RuzickaOndra/Aurora/HW/MermaidControlUnit_A/MermaidControlUnit_Schematic_A.pdf

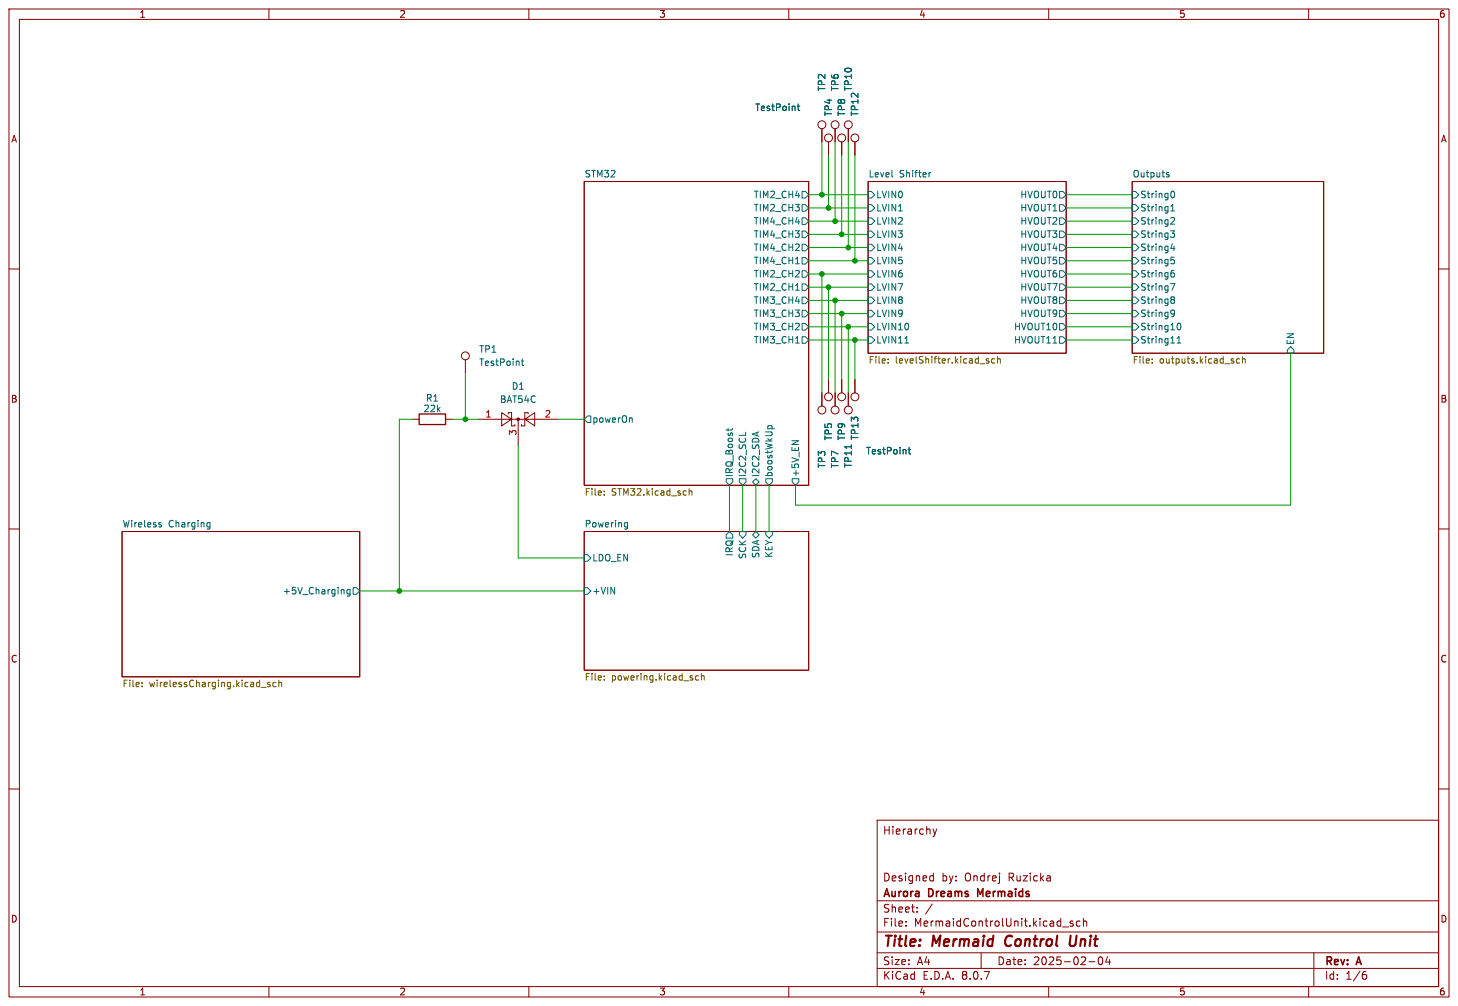
[picture p1: page 1]

Level Shifter File: levelShifter.kicad_sch IRQ SCK SDA KEY LDO_EN

Outputs File: outputs.kicad_sch TIM4_CH3 TIM4_CH4 I2C2_SCL I2C2_SDA boostWkUp

+5V_Charging Wireless Charging File: wirelessCharging.kicad_sch

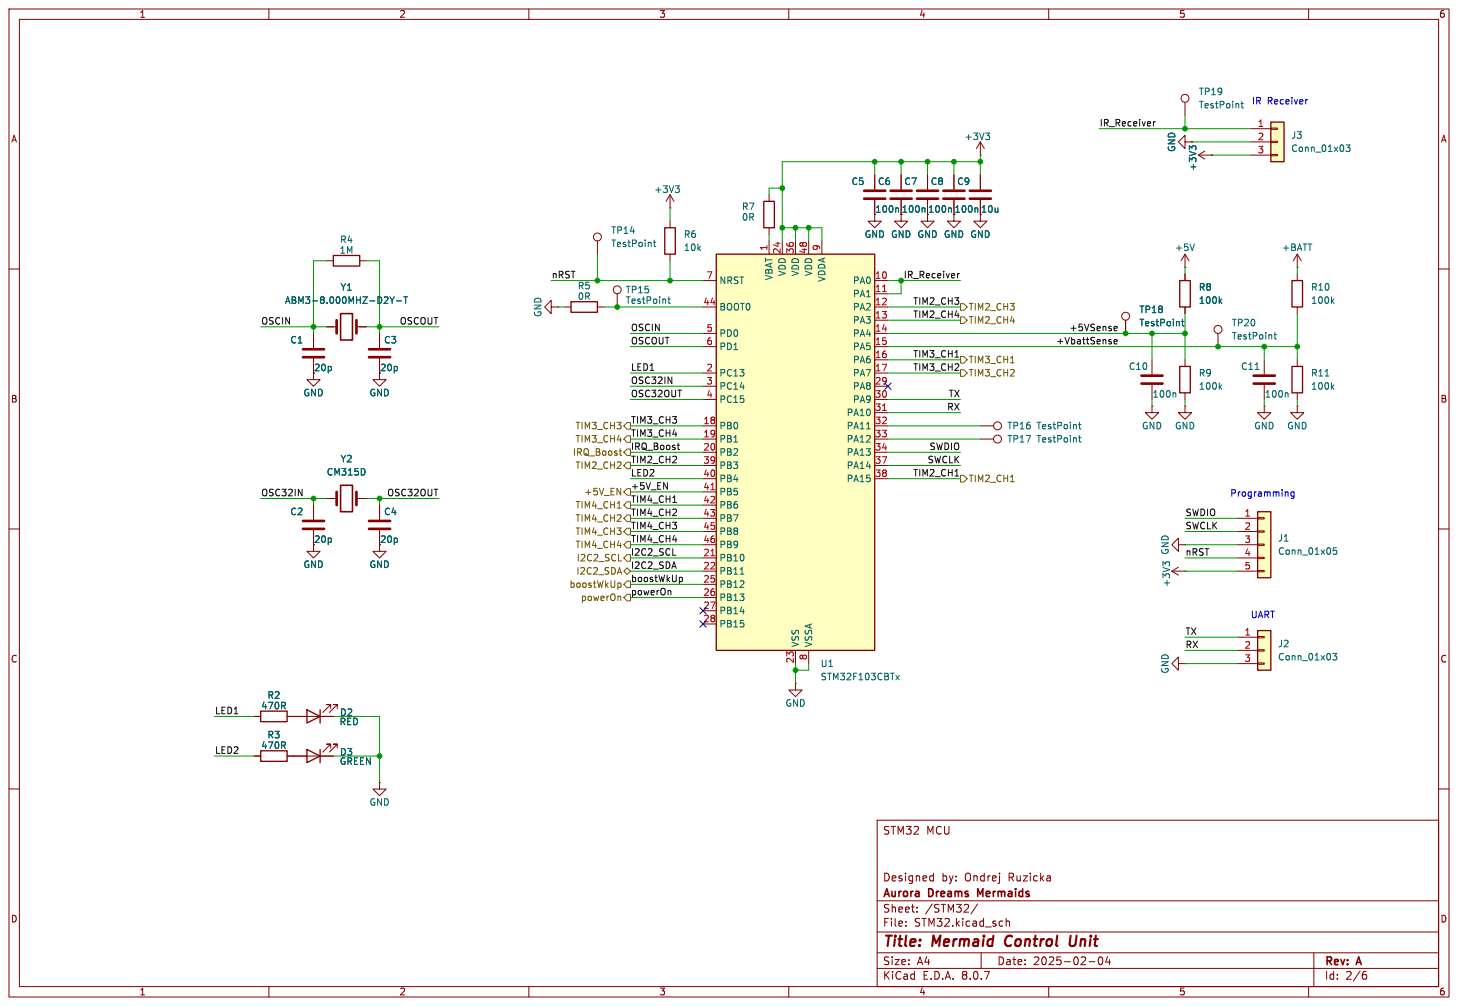
[picture p2: page 2]

IR Receiver GND GND

1 PA0 10 PA1 11 PA2 12 PA3 13 PA4 14 PA5 15 PA6 16 PA7 17 PB0 18 PB1 19 PC13 2 PB2 20 PB10 21 PB11 22 VSS 23 VDD 24 PB12 25 PB13 26 PB14 27 PB15 28 PA8 29 PC14 3 PA9 30 PA10 31 PA11 32 PA12 33 PA13 34 VDD 36 PA14 37 PA15 38 PB3 39 PC15 4 PB4 40 PB5 41 PB6 42 PB7 43 BOOT0 44 PB8 45 PB9 46 VDD 48 PD0 5 PD1 6 NRST 7 VSSA

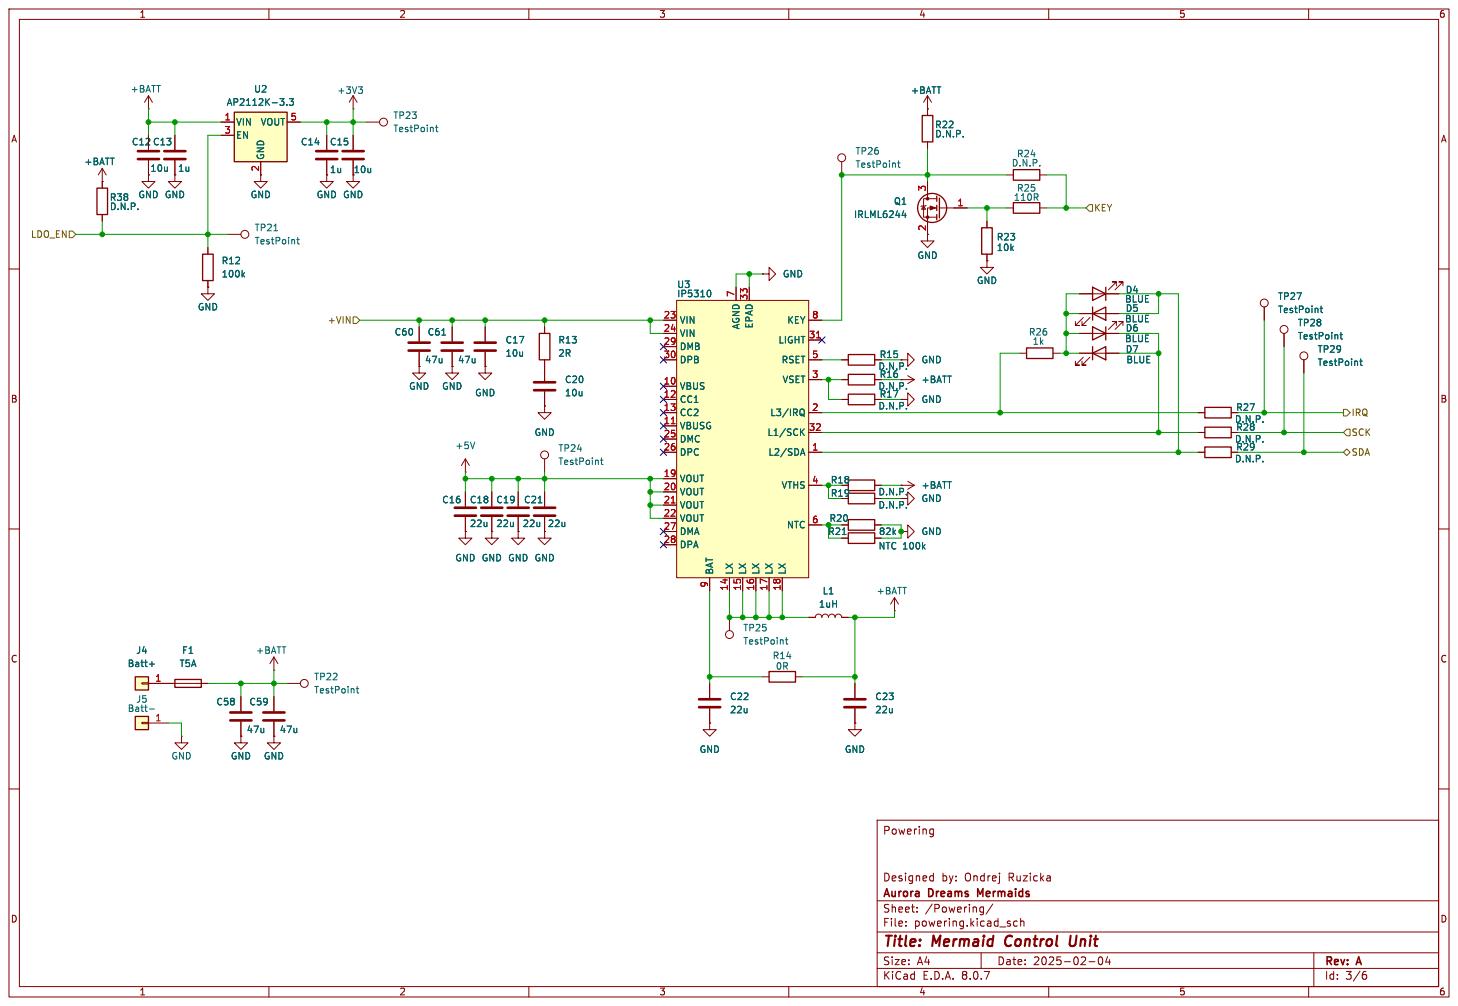
[picture p3: page 3]

TP27 TestPoint TP28 TestPoint TP29 TestPoint GND

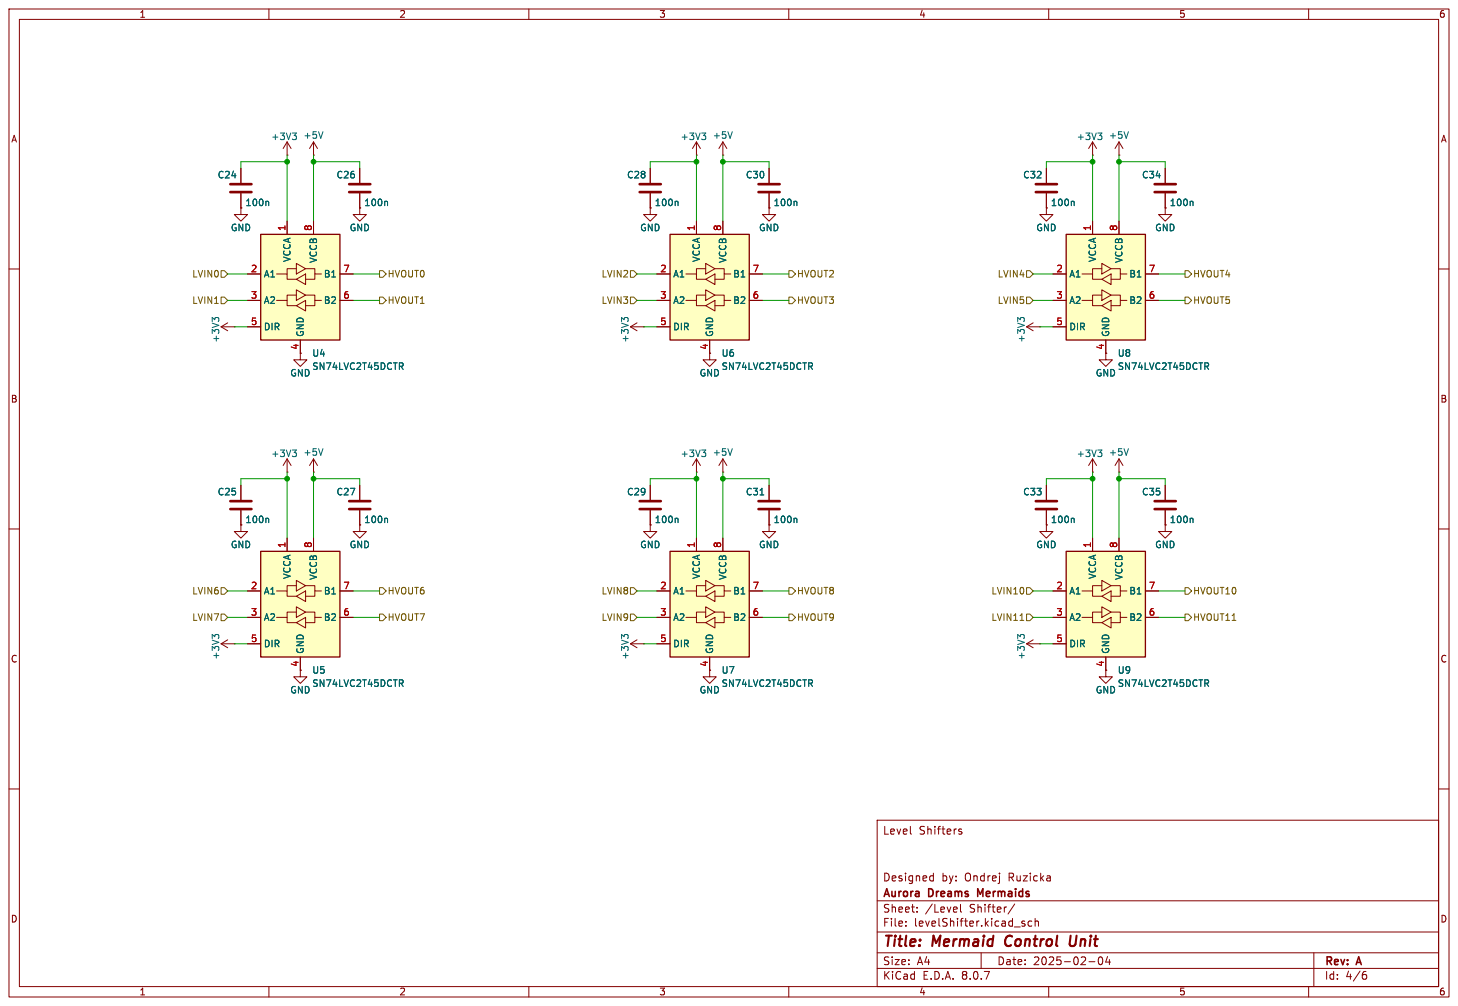
[picture p4: page 4]

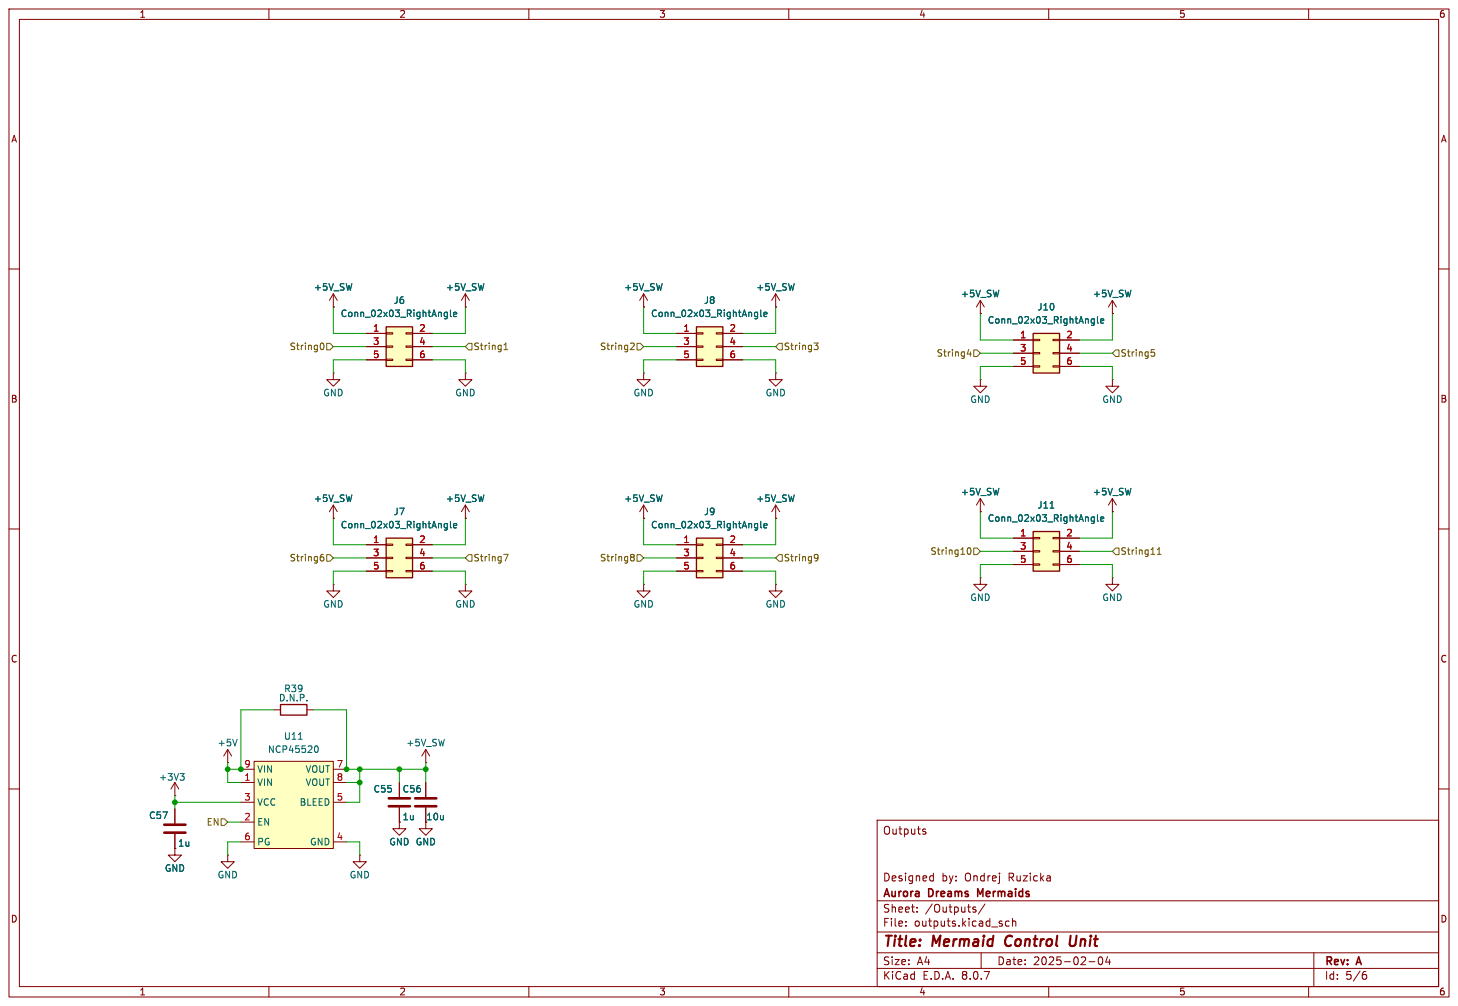
[picture p5: page 5]

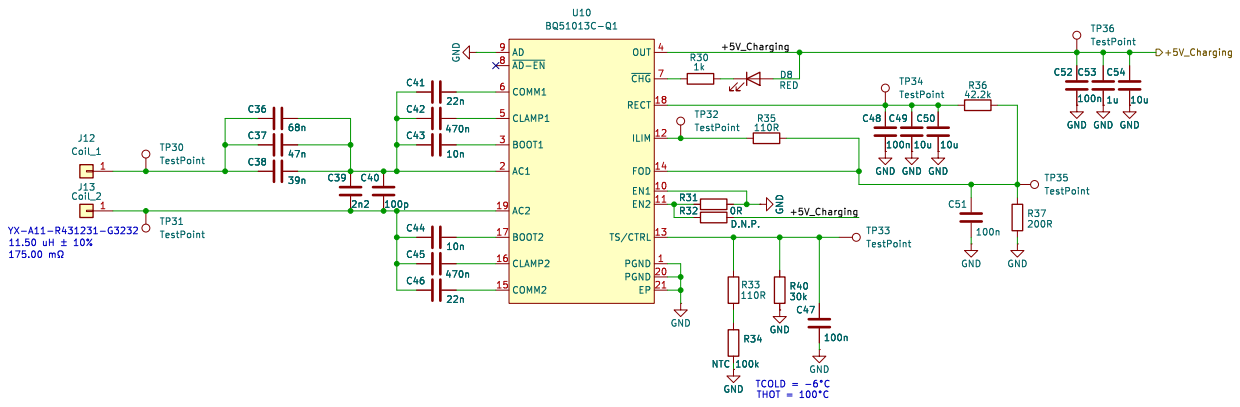
[picture p6: page 6]
