RuzickaOndra/Aurora/HW/Demo/Schematic_Prototype.pdf

A | A

1

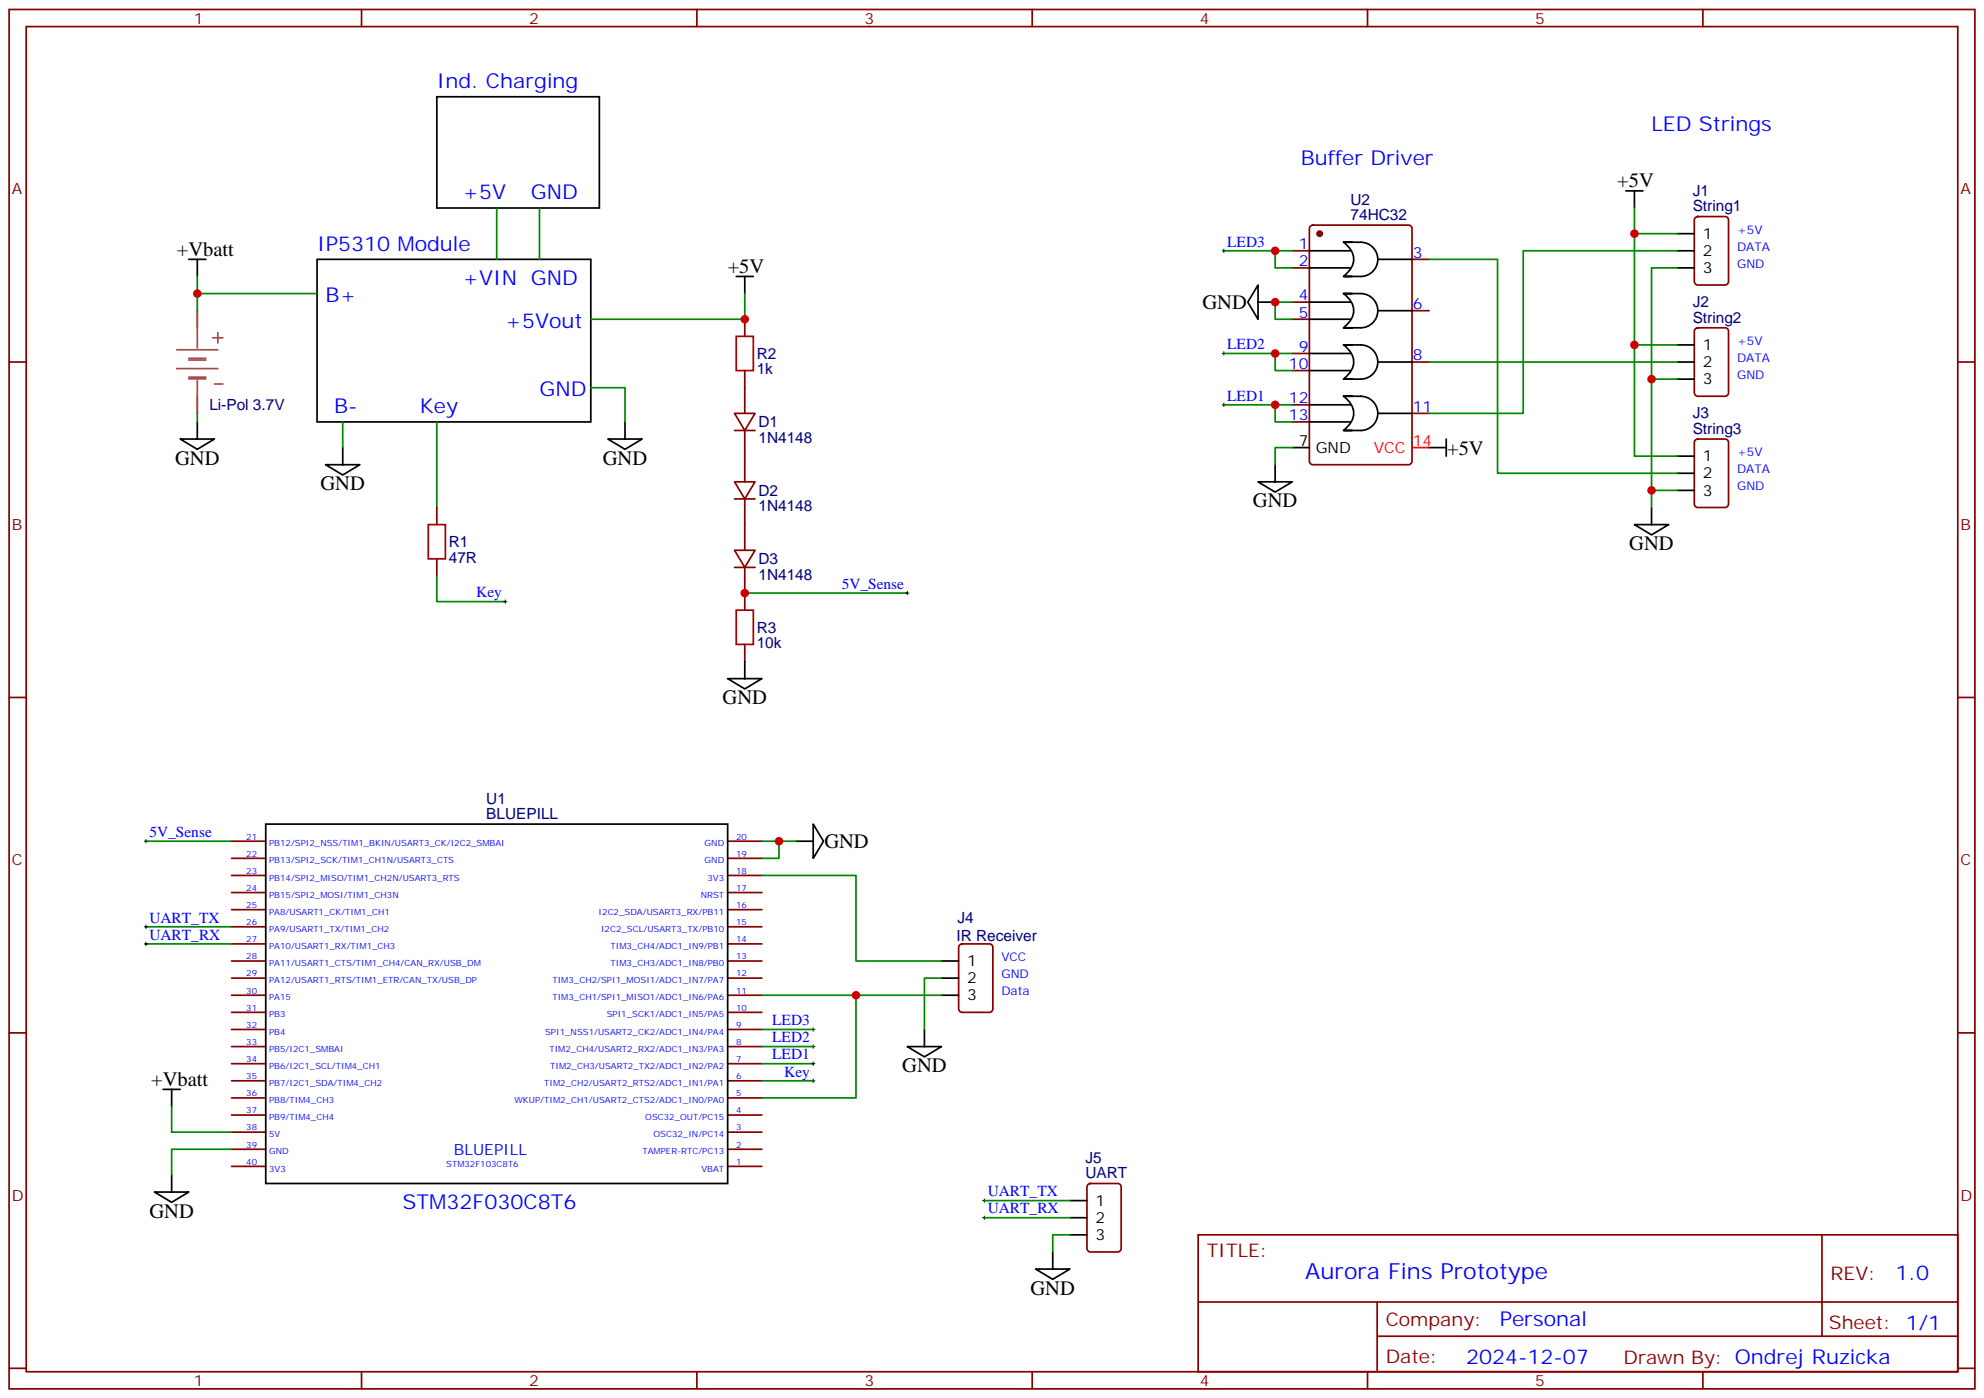
[picture p7: page 1]

Drawn By: Ondrej Ruzicka
