RuzickaOndra/Aurora/HW/MermaidControlUnit_A/KiCAD_Project/MermaidControlUnit.kicad_pcb

## KiCad design HW/MermaidControlUnit_A/KiCAD_Project/MermaidControlUnit.kicad_pcb (2025-03-04)

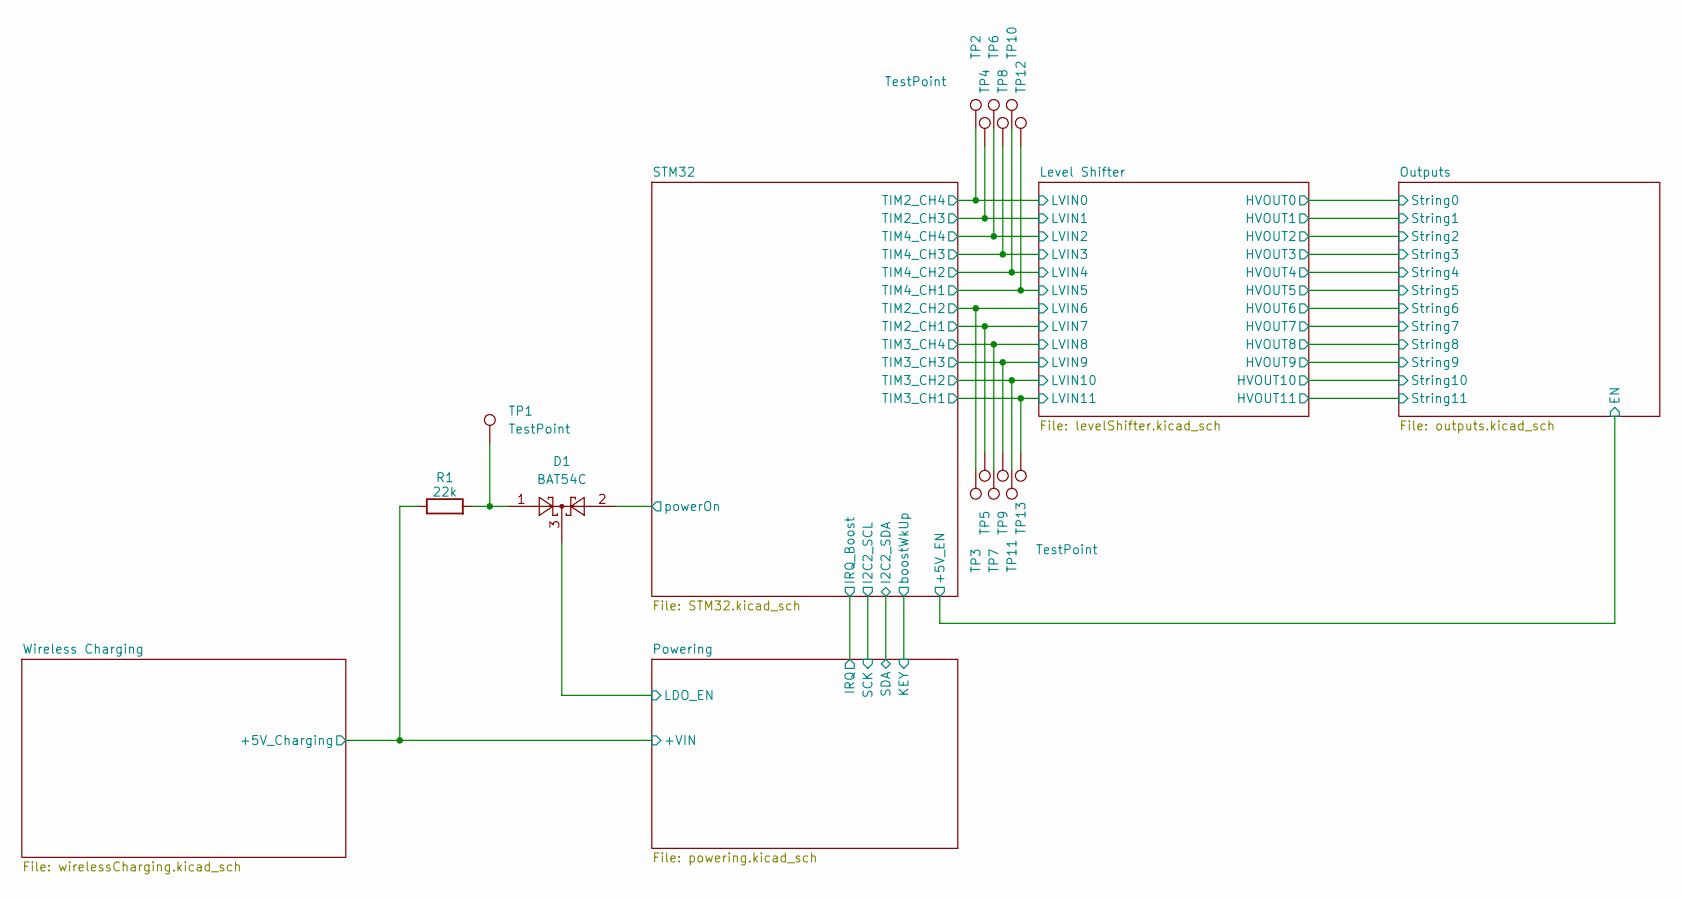
[picture p8: schematic MermaidControlUnit.kicad_sch, Mermaid Control Unit]

Parts:
D1: BAT54C; SOT-23; Part Number BAT54CLT1G
R1: 22k; R_0603_1608Metric; Part Number RC0603FR-0722KL
TP1, TP2, TP3, TP4, TP5, TP6, TP7, TP8, TP9, TP10, TP11, TP12, TP13: TestPoint; TestPoint_Pad_D1.5mm

Connections:
/Powering/LDO_EN: D1.3; also elsewhere on the board
/STM32/TIM2_CH1: TP5.1; also elsewhere on the board
/STM32/TIM2_CH2: TP3.1; also elsewhere on the board
/STM32/TIM2_CH3: TP4.1; also elsewhere on the board
/STM32/TIM2_CH4: TP2.1; also elsewhere on the board
/STM32/TIM3_CH1: TP13.1; also elsewhere on the board
/STM32/TIM3_CH2: TP11.1; also elsewhere on the board
/STM32/TIM3_CH3: TP9.1; also elsewhere on the board
/STM32/TIM3_CH4: TP7.1; also elsewhere on the board
/STM32/TIM4_CH1: TP12.1; also elsewhere on the board
/STM32/TIM4_CH2: TP10.1; also elsewhere on the board
/STM32/TIM4_CH3: TP8.1; also elsewhere on the board
/STM32/TIM4_CH4: TP6.1; also elsewhere on the board
/STM32/powerOn: D1.2; also elsewhere on the board
/Wireless Charging/+5V_Charging: R1.1; also elsewhere on the board
unnamed: D1.1, R1.2, TP1.1

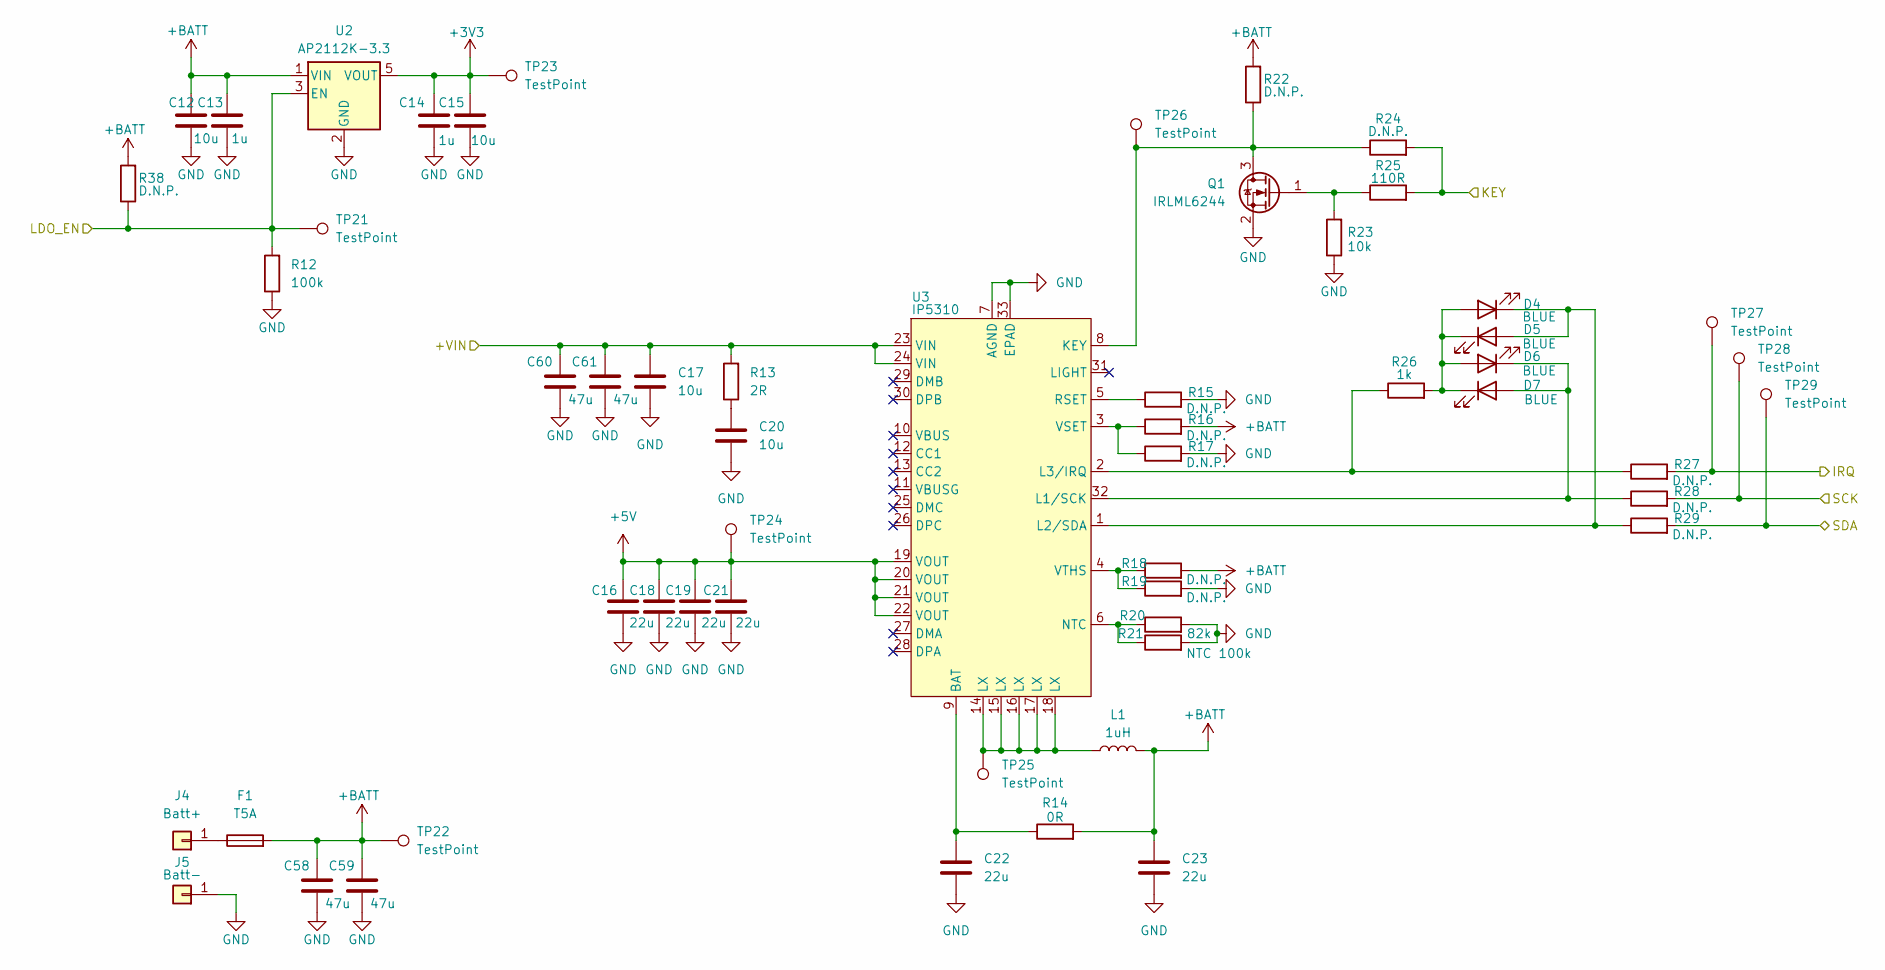
[picture p9: schematic powering.kicad_sch, Mermaid Control Unit]

Parts:
C12, C15, C17, C20: 10u; C_0603_1608Metric; Part Number CL10A106MA8NRNC
C13, C14: 1u; C_0603_1608Metric; Part Number CL10A105KB8NNNC
C16, C18, C19, C21, C22, C23: 22u; C_0603_1608Metric; Part Number CL10A226MP8NUNE
C58, C59, C60, C61: 47u; C_0805_2012Metric; Part Number GRM21BR61A476ME15L
D4, D5, D6, D7: BLUE; LED_0603_1608Metric; Part Number APT1608QBC/D
F1: T5A; Fuse_0603_1608Metric; Part Number F0603HI8000V032TM
J4: Batt+; TestPoint_THTPad_2.0x2.0mm_Drill1.0mm
J5: Batt-; TestPoint_THTPad_2.0x2.0mm_Drill1.0mm
L1: 1uH; L_PCC-M1040M-LP; Part Number ETQP4M1R0KVC
Q1: IRLML6244; SOT-23; Part Number IRLML6244TRPBF
R12: 100k; R_0603_1608Metric; Part Number RC0603FR-07100KL
R13: 2R; R_0603_1608Metric; Part Number FRC0603F2R00TS
R14: 0R; R_0603_1608Metric; Part Number RC0603FR-070RL
R15, R16, R17, R18, R19, R22, R24, R27, R28, R29, R38: D.N.P.; R_0603_1608Metric
R20: 82k; R_0603_1608Metric; Part Number RC0603FR-0782KL
R21: NTC 100k; R_0603_1608Metric; Part Number NCU18WF104F6SRB
R23: 10k; R_0603_1608Metric; Part Number RC0603FR-0710KL
R25: 110R; R_0603_1608Metric; Part Number 0603WAF1100T5E
R26: 1k; R_0603_1608Metric; Part Number RC0603FR-071KL
TP21, TP22, TP23, TP24, TP25, TP26, TP27, TP28, TP29: TestPoint; TestPoint_Pad_D1.5mm
U2: AP2112K-3.3; SOT-23-5; Part Number AP2112K-3.3TRG1
U3: IP5310; QFN-32-1EP_5x5mm_P0.5mm_EP3.6x3.6mm_ThermalVias; Part Number IP5310

Connections:
+3V3: C14.1, C15.1, TP23.1, U2.5 (VOUT); also elsewhere on the board
+5V: C16.1, C18.1, C19.1, C21.1, TP24.1, U3.19 (VOUT), U3.20 (VOUT), U3.21 (VOUT), U3.22 (VOUT); also elsewhere on the board
+BATT: C12.1, C13.1, C23.1, C58.1, C59.1, F1.2, L1.2, R14.2, R16.2, R18.2, R22.2, R38.2, TP22.1, U2.1 (VIN); also elsewhere on the board
/Powering/LDO_EN: R12.2, R38.1, TP21.1, U2.3 (EN); also elsewhere on the board
/STM32/I2C2_SCL: R28.2, TP28.1; also elsewhere on the board
/STM32/I2C2_SDA: R29.2, TP29.1; also elsewhere on the board
/STM32/IRQ_Boost: R27.2, TP27.1; also elsewhere on the board
/STM32/boostWkUp: R24.2, R25.2; also elsewhere on the board
/Wireless Charging/+5V_Charging: C17.1, C60.1, C61.1, R13.2, U3.23 (VIN), U3.24 (VIN); also elsewhere on the board
GND: C12.2, C13.2, C14.2, C15.2, C16.2, C17.2, C18.2, C19.2, C20.2, C21.2, C22.2, C23.2, C58.2, C59.2, C60.2, C61.2, J5.1, Q1.2 (S), R12.1, R15.2, R17.2, R19.2, R20.2, R21.2, R23.1, U2.2 (GND), U3.7 (AGND), U3.33 (EPAD); also elsewhere on the board
unnamed: C20.1, R13.1
unnamed: D4.2 (A), D5.1 (K), D6.2 (A), D7.1 (K), R26.2
unnamed: D4.1 (K), D5.2 (A), R29.1, U3.1 (L2/SDA)
unnamed: D6.1 (K), D7.2 (A), R28.1, U3.32 (L1/SCK)
unnamed: F1.1, J4.1
unnamed: L1.1, TP25.1, U3.14 (LX), U3.15 (LX), U3.16 (LX), U3.17 (LX), U3.18 (LX)
unnamed: Q1.3 (D), R22.1, R24.1, TP26.1, U3.8 (KEY)
unnamed: Q1.1 (G), R23.2, R25.1
unnamed: C22.1, R14.1, U3.9 (BAT)
unnamed: R26.1, R27.1, U3.2 (L3/IRQ)
unnamed: R20.1, R21.1, U3.6 (NTC)
unnamed: R15.1, U3.5 (RSET)
unnamed: R16.1, R17.1, U3.3 (VSET)
unnamed: R18.1, R19.1, U3.4 (VTHS)

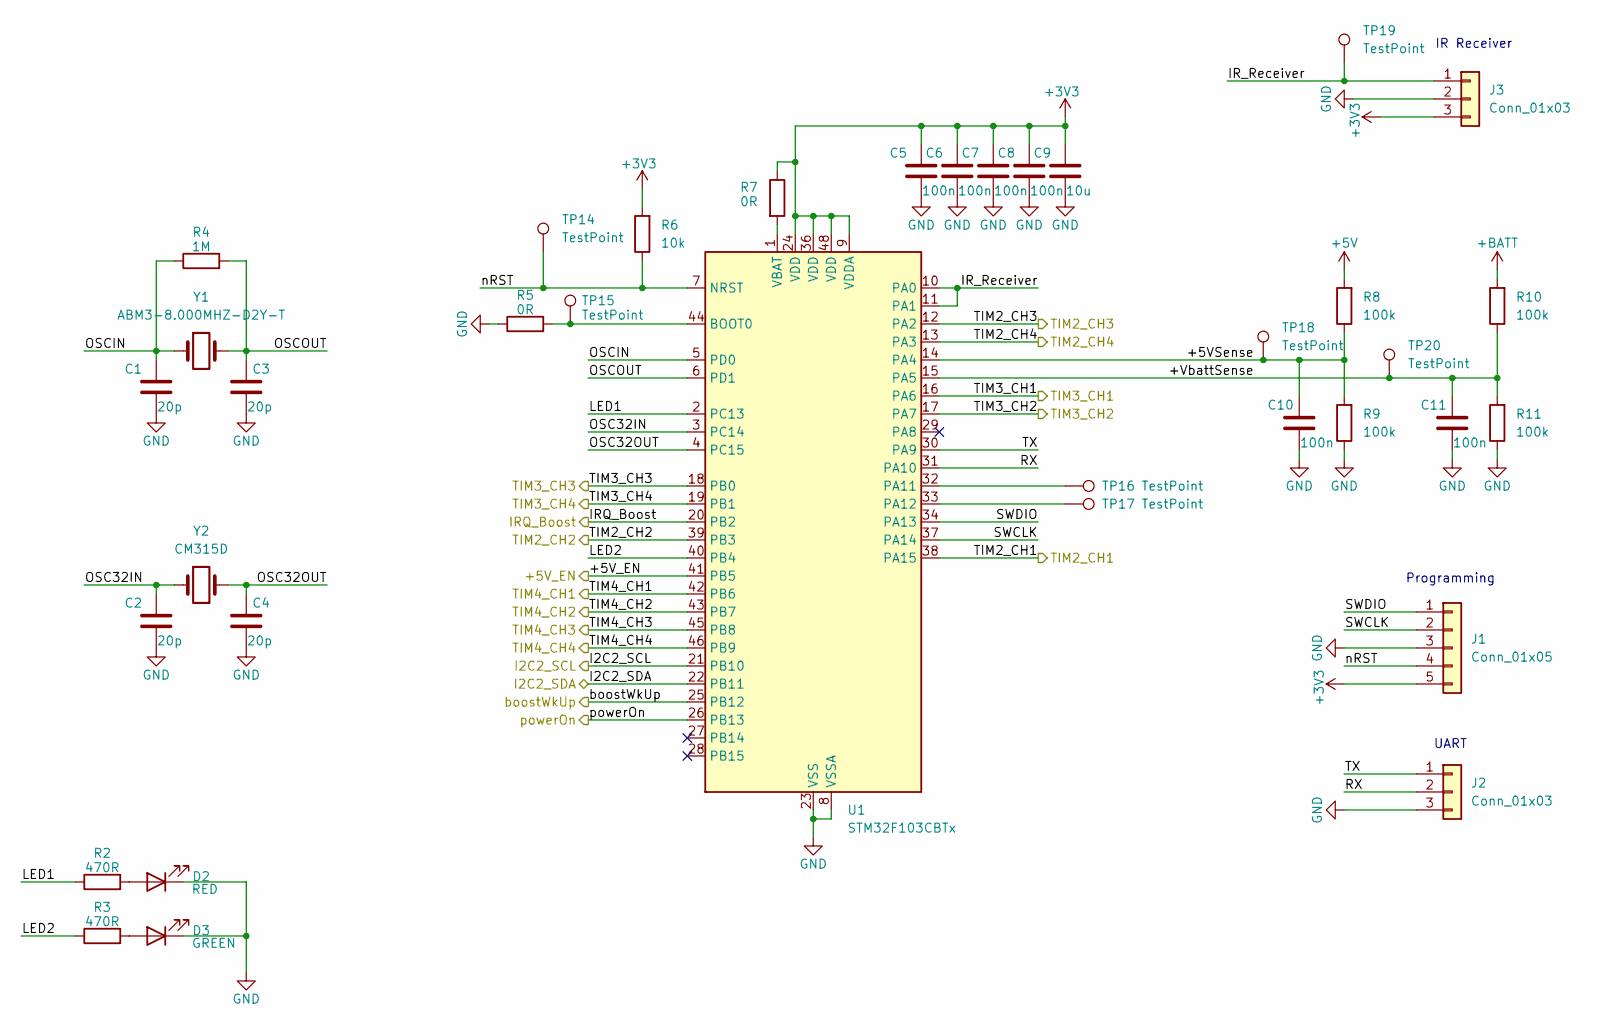
[picture p10: schematic STM32.kicad_sch, Mermaid Control Unit]

Parts:
C1, C2, C3, C4: 20p; C_0603_1608Metric; Part Number GCM1885C1H200JA16D
C5, C6, C7, C8, C10, C11: 100n; C_0603_1608Metric; Part Number CC0603KRX7R9BB104
C9: 10u; C_0603_1608Metric; Part Number CL10A106MA8NRNC
D2: RED; LED_0603_1608Metric; Part Number APT1608EC
D3: GREEN; LED_0603_1608Metric; Part Number APT1608CGCK
J1: Conn_01x05; PinHeader_1x05_P2.54mm_Horizontal_SmallSilk; Part Number 5AMW4-10560-105-W0
J2, J3: Conn_01x03; PinHeader_1x03_P2.54mm_Horizontal_SmallSilk; Part Number X6511WR-03H-C60D30R2
R2, R3: 470R; R_0603_1608Metric; Part Number RC0603FR-07470RL
R4: 1M; R_0603_1608Metric; Part Number RC0603FR-071ML
R5, R7: 0R; R_0603_1608Metric; Part Number RC0603FR-070RL
R6: 10k; R_0603_1608Metric; Part Number RC0603FR-0710KL
R8, R9, R10, R11: 100k; R_0603_1608Metric; Part Number RC0603FR-07100KL
TP14, TP15, TP16, TP17, TP18, TP19, TP20: TestPoint; TestPoint_Pad_D1.5mm
U1: STM32F103CBTx; LQFP-48_7x7mm_P0.5mm
Y1: ABM3-8.000MHZ-D2Y-T; Crystal_SMD_Abracon_ABM3-2Pin_5.0x3.2mm; Part Number ABM3-8.000MHZ-D2Y-T
Y2: CM315D; Crystal_SMD_3215-2Pin_3.2x1.5mm; Part Number CM315D32768DZFT

Connections:
+3V3: C5.1, C6.1, C7.1, C8.1, C9.1, J1.5, J3.3, R6.2, R7.1, U1.9 (VDDA), U1.24 (VDD), U1.36 (VDD), U1.48 (VDD); also elsewhere on the board
+5V: R8.2; also elsewhere on the board
+BATT: R10.2; also elsewhere on the board
/STM32/+5VSense: C10.1, R8.1, R9.2, TP18.1, U1.14 (PA4)
/STM32/+5V_EN: U1.41 (PB5); also elsewhere on the board
/STM32/+VbattSense: C11.1, R10.1, R11.2, TP20.1, U1.15 (PA5)
/STM32/I2C2_SCL: U1.21 (PB10); also elsewhere on the board
/STM32/I2C2_SDA: U1.22 (PB11); also elsewhere on the board
/STM32/IRQ_Boost: U1.20 (PB2); also elsewhere on the board
/STM32/IR_Receiver: J3.1, TP19.1, U1.10 (PA0), U1.11 (PA1)
/STM32/LED1: R2.1, U1.2 (PC13)
/STM32/LED2: R3.1, U1.40 (PB4)
/STM32/OSC32IN: C2.1, U1.3 (PC14), Y2.1
/STM32/OSC32OUT: C4.1, U1.4 (PC15), Y2.2
/STM32/OSCIN: C1.1, R4.1, U1.5 (PD0), Y1.1
/STM32/OSCOUT: C3.1, R4.2, U1.6 (PD1), Y1.2
/STM32/RX: J2.2, U1.31 (PA10)
/STM32/SWCLK: J1.2, U1.37 (PA14)
/STM32/SWDIO: J1.1, U1.34 (PA13)
/STM32/TIM2_CH1: U1.38 (PA15); also elsewhere on the board
/STM32/TIM2_CH2: U1.39 (PB3); also elsewhere on the board
/STM32/TIM2_CH3: U1.12 (PA2); also elsewhere on the board
/STM32/TIM2_CH4: U1.13 (PA3); also elsewhere on the board
/STM32/TIM3_CH1: U1.16 (PA6); also elsewhere on the board
/STM32/TIM3_CH2: U1.17 (PA7); also elsewhere on the board
/STM32/TIM3_CH3: U1.18 (PB0); also elsewhere on the board
/STM32/TIM3_CH4: U1.19 (PB1); also elsewhere on the board
/STM32/TIM4_CH1: U1.42 (PB6); also elsewhere on the board
/STM32/TIM4_CH2: U1.43 (PB7); also elsewhere on the board
/STM32/TIM4_CH3: U1.45 (PB8); also elsewhere on the board
/STM32/TIM4_CH4: U1.46 (PB9); also elsewhere on the board
/STM32/TX: J2.1, U1.30 (PA9)
/STM32/boostWkUp: U1.25 (PB12); also elsewhere on the board
/STM32/nRST: J1.4, R6.1, TP14.1, U1.7 (NRST)
/STM32/powerOn: U1.26 (PB13); also elsewhere on the board
GND: C1.2, C2.2, C3.2, C4.2, C5.2, C6.2, C7.2, C8.2, C9.2, C10.2, C11.2, D2.1 (K), D3.1 (K), J1.3, J2.3, J3.2, R5.1, R9.1, R11.1, U1.8 (VSSA), U1.23 (VSS), U1.35 (VSS), U1.47 (VSS); also elsewhere on the board
unnamed: D2.2 (A), R2.2
unnamed: D3.2 (A), R3.2
unnamed: R5.2, TP15.1, U1.44 (BOOT0)
unnamed: TP16.1, U1.32 (PA11)
unnamed: TP17.1, U1.33 (PA12)
unnamed: R7.2, U1.1 (VBAT)

Notes on the sheet:
Programming
UART
IR Receiver

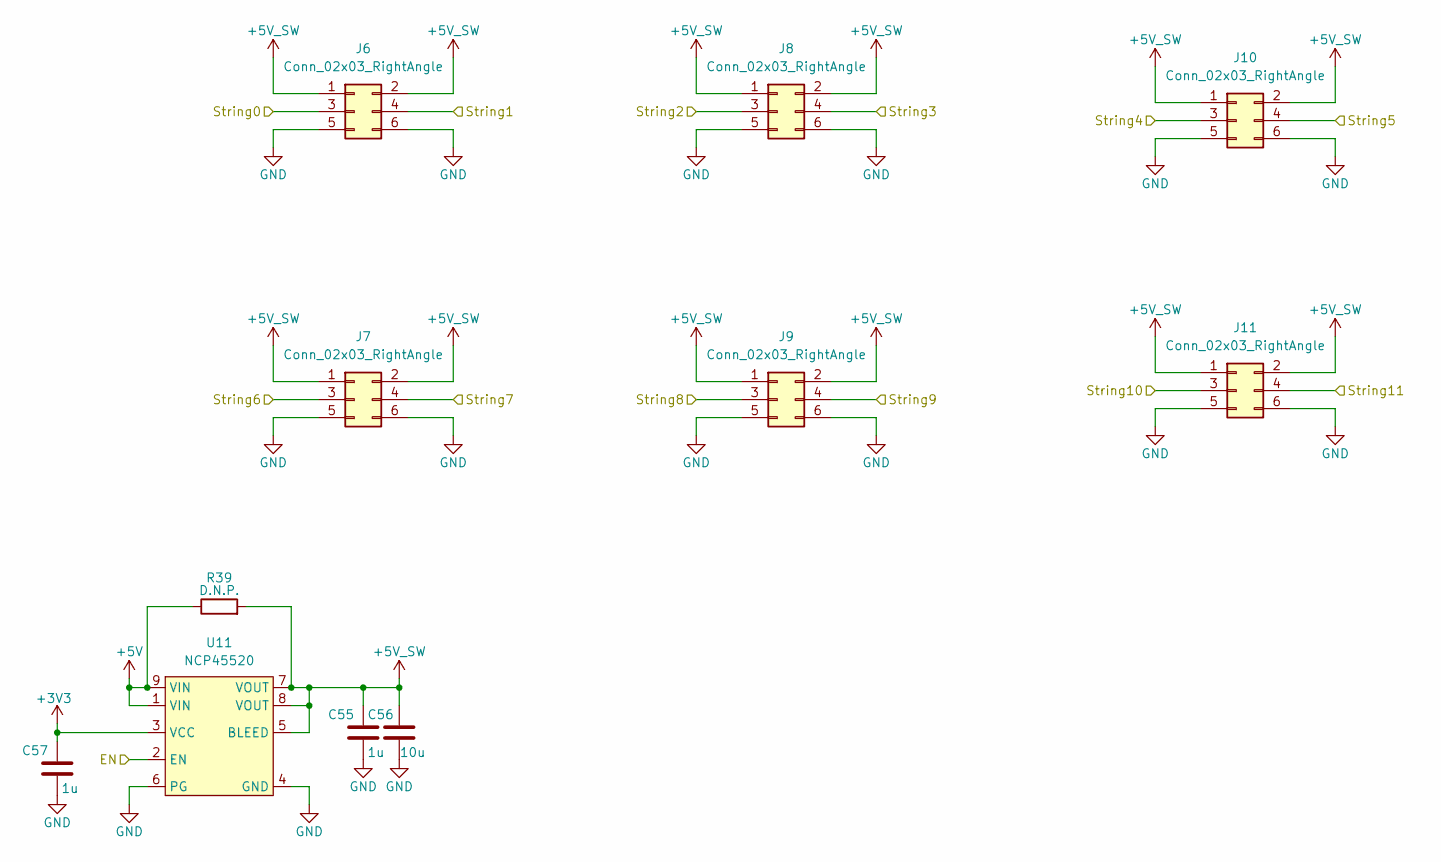
[picture p11: schematic outputs.kicad_sch, Mermaid Control Unit]

Parts:
C55, C57: 1u; C_0603_1608Metric; Part Number CL10A105KB8NNNC
C56: 10u; C_0603_1608Metric; Part Number CL10A106MA8NRNC
J6, J7, J8, J9, J10, J11: Conn_02x03_RightAngle; PinHeader_2x03_P2.54mm_Horizontal_SmallSilk; Part Number BX-PZ2.54-2-3PWZ
R39: D.N.P.; R_0603_1608Metric
U11: NCP45520; DFN-8-1EP_2x2mm_P0.5mm_EP1.05x1.75mm; Part Number NCP45520IMNTWG-H

Connections:
+3V3: C57.1, U11.3 (VCC); also elsewhere on the board
+5V: R39.1, U11.1 (VIN), U11.9 (VIN); also elsewhere on the board
+5V_SW: C55.1, C56.1, J6.1, J6.2, J7.1, J7.2, J8.1, J8.2, J9.1, J9.2, J10.1, J10.2, J11.1, J11.2, R39.2, U11.5 (BLEED), U11.7 (VOUT), U11.8 (VOUT)
/Level Shifter/HVOUT0: J6.3; also elsewhere on the board
/Level Shifter/HVOUT1: J6.4; also elsewhere on the board
/Level Shifter/HVOUT2: J8.3; also elsewhere on the board
/Level Shifter/HVOUT3: J8.4; also elsewhere on the board
/Level Shifter/HVOUT4: J10.3; also elsewhere on the board
/Level Shifter/HVOUT5: J10.4; also elsewhere on the board
/Level Shifter/HVOUT6: J7.3; also elsewhere on the board
/Level Shifter/HVOUT7: J7.4; also elsewhere on the board
/Level Shifter/HVOUT8: J9.3; also elsewhere on the board
/Level Shifter/HVOUT9: J9.4; also elsewhere on the board
/Level Shifter/HVOUT10: J11.3; also elsewhere on the board
/Level Shifter/HVOUT11: J11.4; also elsewhere on the board
/STM32/+5V_EN: U11.2 (EN); also elsewhere on the board
GND: C55.2, C56.2, C57.2, J6.5, J6.6, J7.5, J7.6, J8.5, J8.6, J9.5, J9.6, J10.5, J10.6, J11.5, J11.6, U11.4 (GND), U11.6 (PG); also elsewhere on the board

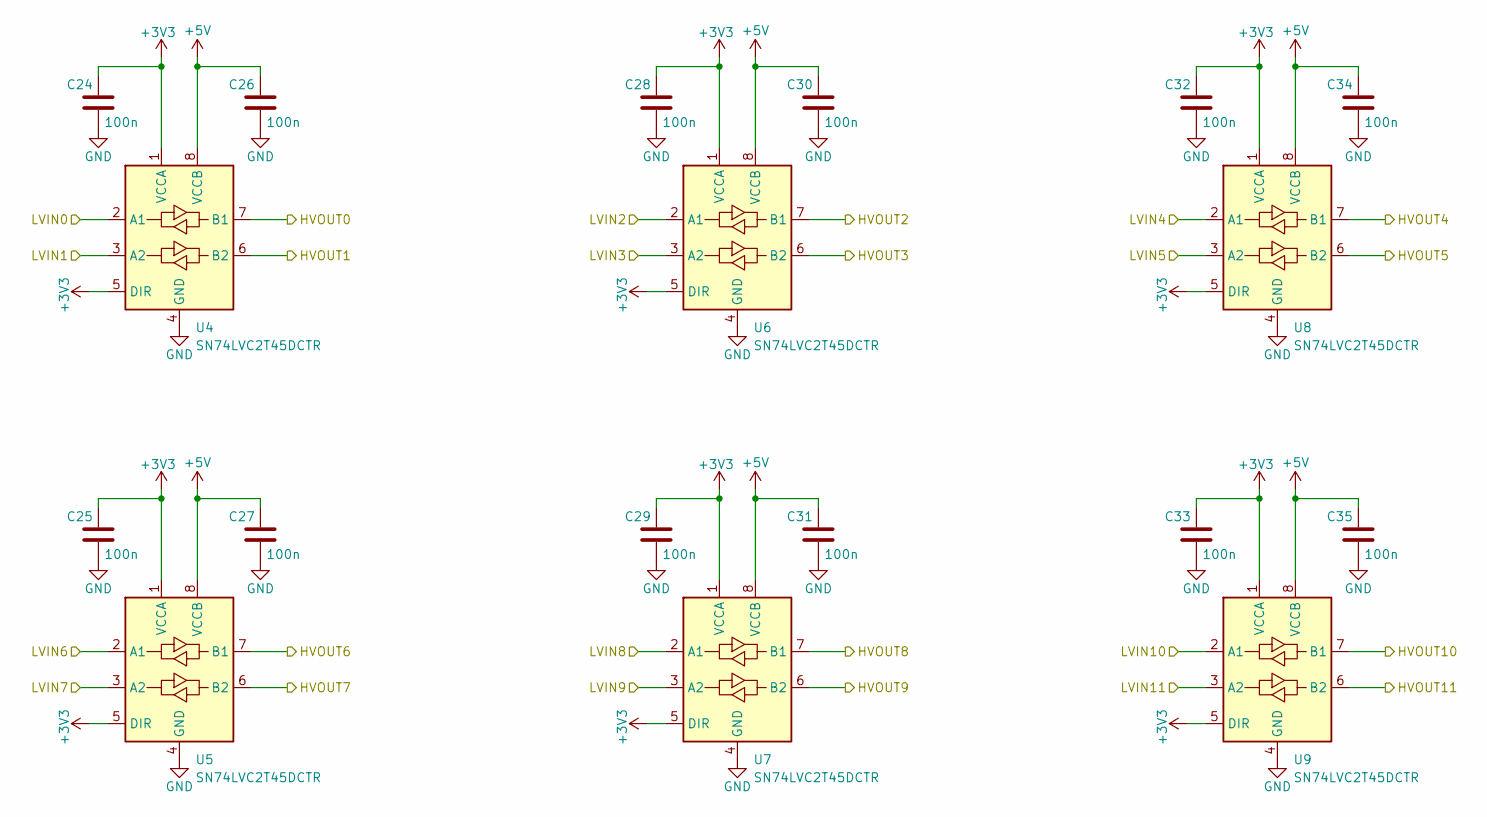
[picture p12: schematic levelShifter.kicad_sch, Mermaid Control Unit]

Parts:
C24, C25, C26, C27, C28, C29, C30, C31, C32, C33, C34, C35: 100n; C_0603_1608Metric; Part Number CC0603KRX7R9BB104
U4, U5, U6, U7, U8, U9: SN74LVC2T45DCTR; SSOP-8_2.95x2.8mm_P0.65mm; Part Number SN74LVC2T45DCTR

Connections:
+3V3: C24.1, C25.1, C28.1, C29.1, C32.1, C33.1, U4.1 (VCCA), U4.5 (DIR), U5.1 (VCCA), U5.5 (DIR), U6.1 (VCCA), U6.5 (DIR), U7.1 (VCCA), U7.5 (DIR), U8.1 (VCCA), U8.5 (DIR), U9.1 (VCCA), U9.5 (DIR); also elsewhere on the board
+5V: C26.1, C27.1, C30.1, C31.1, C34.1, C35.1, U4.8 (VCCB), U5.8 (VCCB), U6.8 (VCCB), U7.8 (VCCB), U8.8 (VCCB), U9.8 (VCCB); also elsewhere on the board
/Level Shifter/HVOUT0: U4.7 (B1); also elsewhere on the board
/Level Shifter/HVOUT1: U4.6 (B2); also elsewhere on the board
/Level Shifter/HVOUT2: U6.7 (B1); also elsewhere on the board
/Level Shifter/HVOUT3: U6.6 (B2); also elsewhere on the board
/Level Shifter/HVOUT4: U8.7 (B1); also elsewhere on the board
/Level Shifter/HVOUT5: U8.6 (B2); also elsewhere on the board
/Level Shifter/HVOUT6: U5.7 (B1); also elsewhere on the board
/Level Shifter/HVOUT7: U5.6 (B2); also elsewhere on the board
/Level Shifter/HVOUT8: U7.7 (B1); also elsewhere on the board
/Level Shifter/HVOUT9: U7.6 (B2); also elsewhere on the board
/Level Shifter/HVOUT10: U9.7 (B1); also elsewhere on the board
/Level Shifter/HVOUT11: U9.6 (B2); also elsewhere on the board
/STM32/TIM2_CH1: U5.3 (A2); also elsewhere on the board
/STM32/TIM2_CH2: U5.2 (A1); also elsewhere on the board
/STM32/TIM2_CH3: U4.3 (A2); also elsewhere on the board
/STM32/TIM2_CH4: U4.2 (A1); also elsewhere on the board
/STM32/TIM3_CH1: U9.3 (A2); also elsewhere on the board
/STM32/TIM3_CH2: U9.2 (A1); also elsewhere on the board
/STM32/TIM3_CH3: U7.3 (A2); also elsewhere on the board
/STM32/TIM3_CH4: U7.2 (A1); also elsewhere on the board
/STM32/TIM4_CH1: U8.3 (A2); also elsewhere on the board
/STM32/TIM4_CH2: U8.2 (A1); also elsewhere on the board
/STM32/TIM4_CH3: U6.3 (A2); also elsewhere on the board
/STM32/TIM4_CH4: U6.2 (A1); also elsewhere on the board
GND: C24.2, C25.2, C26.2, C27.2, C28.2, C29.2, C30.2, C31.2, C32.2, C33.2, C34.2, C35.2, U4.4 (GND), U5.4 (GND), U6.4 (GND), U7.4 (GND), U8.4 (GND), U9.4 (GND); also elsewhere on the board

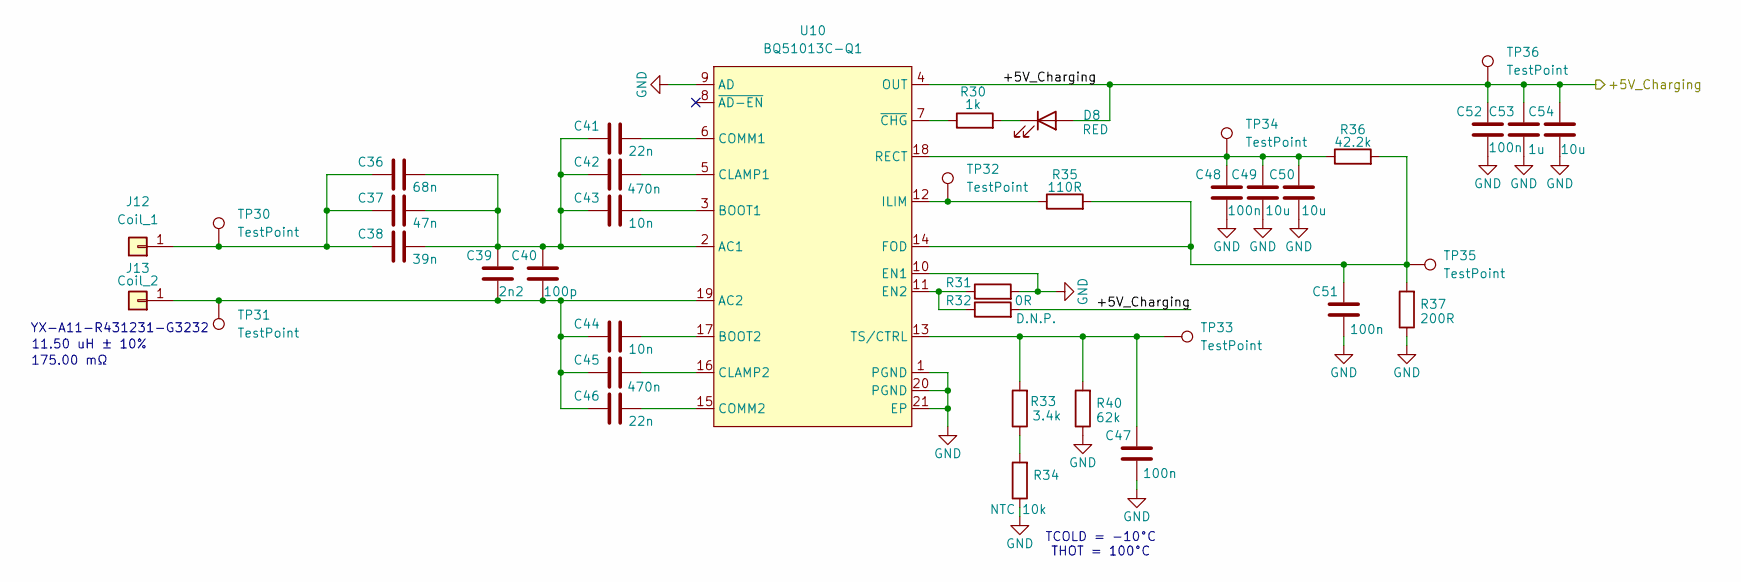
[picture p13: schematic wirelessCharging.kicad_sch, Mermaid Control Unit]

Parts:
C36: 68n; C_0603_1608Metric; Part Number GCJ188R71H683KA12D
C37: 47n; C_0603_1608Metric; Part Number CGA3E2X7R1H473KT0Y0N
C38: 39n; C_0603_1608Metric; Part Number CL10B393KB8NNNC
C39: 2n2; C_0603_1608Metric; Part Number GRM1885C2A222JA01D
C40: 100p; C_0603_1608Metric; Part Number CGA3E2C0G1H101JT0Y0N
C41, C46: 22n; C_0603_1608Metric; Part Number C1608X7R1H223KT000N
C42, C45: 470n; C_0603_1608Metric; Part Number CL10B474KB8VPNC
C43, C44: 10n; C_0603_1608Metric; Part Number 06035C103JAT2A
C47, C48, C51, C52: 100n; C_0603_1608Metric; Part Number CC0603KRX7R9BB104
C49, C50, C54: 10u; C_0603_1608Metric; Part Number CL10A106MA8NRNC
C53: 1u; C_0603_1608Metric; Part Number CL10A105KB8NNNC
D8: RED; LED_0603_1608Metric; Part Number APT1608EC
J12: Coil_1; TestPoint_THTPad_2.0x2.0mm_Drill1.0mm
J13: Coil_2; TestPoint_THTPad_2.0x2.0mm_Drill1.0mm
R30: 1k; R_0603_1608Metric; Part Number RC0603FR-071KL
R31: 0R; R_0603_1608Metric; Part Number RC0603FR-070RL
R32: D.N.P.; R_0603_1608Metric
R33: 3.4k; R_0603_1608Metric; Part Number 0603WAF4301T5E
R34: NTC 10k; R_0603_1608Metric; Part Number NTCG163JF103FTDS
R35: 110R; R_0603_1608Metric; Part Number 0603WAF1100T5E
R36: 42.2k; R_0603_1608Metric; Part Number WR06X4222FTL
R37: 200R; R_0603_1608Metric; Part Number 0603WAF2000T5E
R40: 62k; R_0603_1608Metric; Part Number 0603WAF6202T5E
TP30, TP31, TP32, TP33, TP34, TP35, TP36: TestPoint; TestPoint_Pad_D1.5mm
U10: BQ51013C-Q1; Texas_VQFN-RHL-20_ThermalVias; Part Number BQ51013C-Q1

Connections:
/Wireless Charging/+5V_Charging: C52.1, C53.1, C54.1, D8.2 (A), R32.2, TP36.1, U10.4 (OUT); also elsewhere on the board
GND: C47.2, C48.2, C49.2, C50.2, C51.2, C52.2, C53.2, C54.2, R31.2, R34.1, R37.1, R40.1, U10.1 (PGND), U10.9 (AD), U10.10 (EN1), U10.20 (PGND), U10.21 (EP); also elsewhere on the board
unnamed: D8.1 (K), R30.2
unnamed: C36.1, C37.1, C38.1, J12.1, TP30.1
unnamed: C39.2, C40.2, C44.1, C45.1, C46.1, J13.1, TP31.1, U10.19 (AC2)
unnamed: R33.1, R34.2
unnamed: C36.2, C37.2, C38.2, C39.1, C40.1, C41.1, C42.1, C43.1, U10.2 (AC1)
unnamed: C43.2, U10.3 (BOOT1)
unnamed: C44.2, U10.17 (BOOT2)
unnamed: C42.2, U10.5 (CLAMP1)
unnamed: C45.2, U10.16 (CLAMP2)
unnamed: C41.2, U10.6 (COMM1)
unnamed: C46.2, U10.15 (COMM2)
unnamed: R31.1, R32.1, U10.11 (EN2)
unnamed: C51.1, R35.2, R36.2, R37.2, TP35.1, U10.14 (FOD)
unnamed: R35.1, TP32.1, U10.12 (ILIM)
unnamed: C48.1, C49.1, C50.1, R36.1, TP34.1, U10.18 (RECT)
unnamed: C47.1, R33.2, R40.2, TP33.1, U10.13 (TS/CTRL)
unnamed: R30.1, U10.7 (~CHG)

Notes on the sheet:
175.00 mΩ
11.50 uH ± 10%
YX-A11-R431231-G3232
TCOLD = -10°C THOT = 100°C

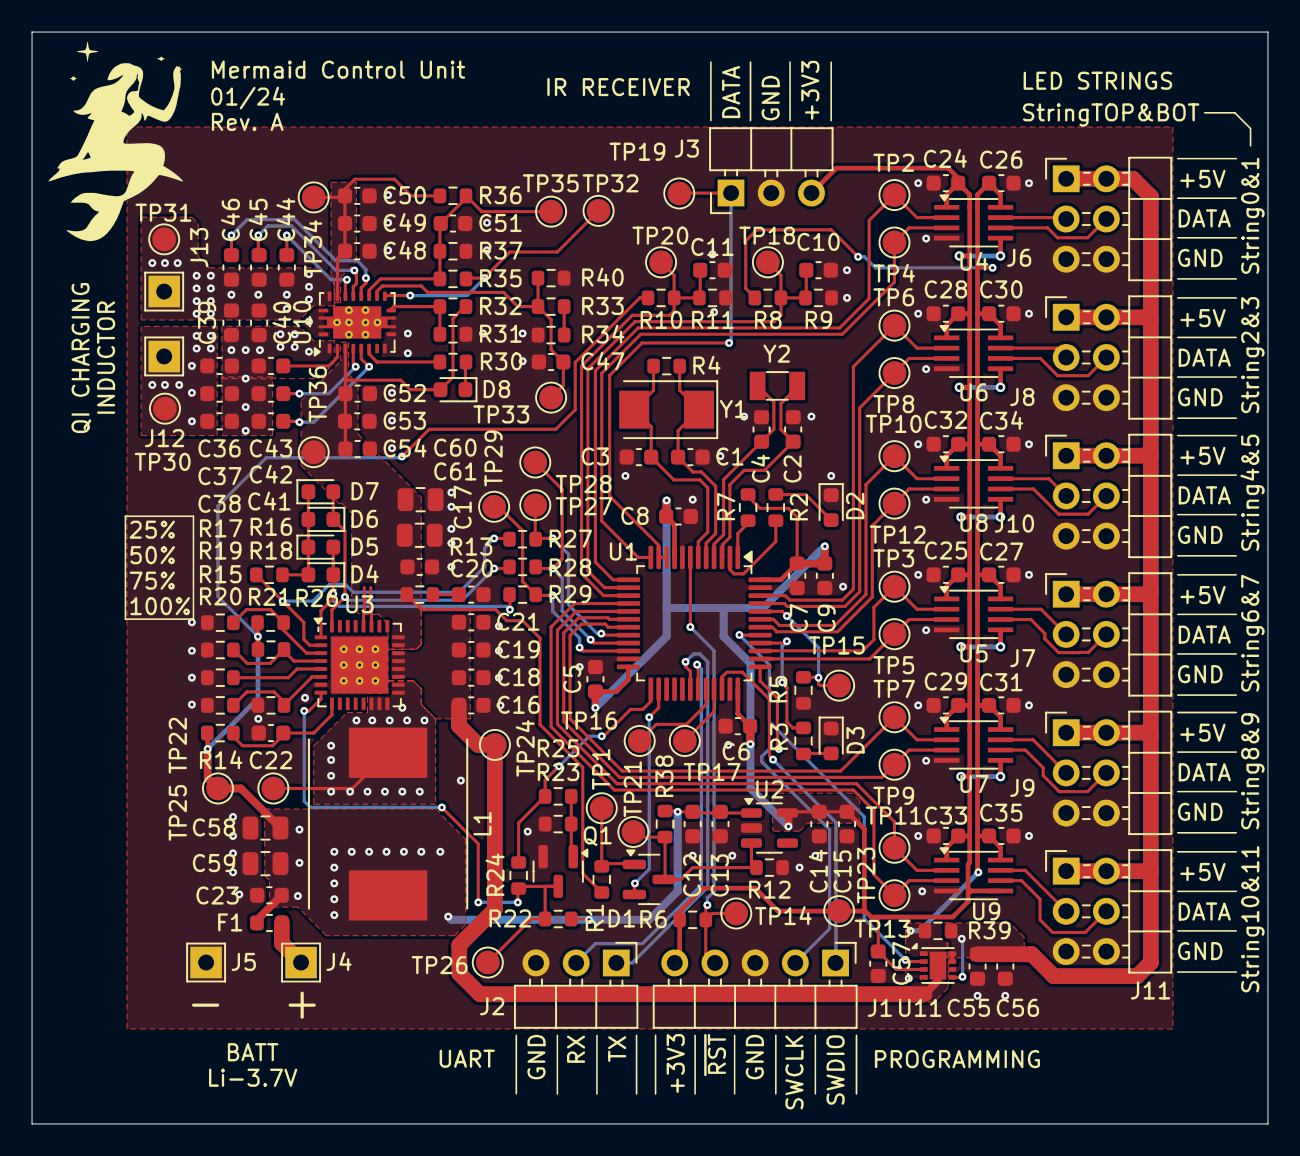
[picture p14: board MermaidControlUnit.kicad_pcb from above]

Board: 2 copper layers, 78.1 x 69.0 mm, 174 parts (0 on the bottom side), 89 nets.
