RuzickaOndra/Aurora/FW/MermaidControlUnit_A/MermaidControlUnit_A.ioc

Mcu.UserName=STM32F103CBTx
PA1.Signal=GPXTI1
PA10.Signal=USART1_RX
PA13.Signal=SYS_JTMS-SWDIO
PA14.Signal=SYS_JTCK-SWCLK
PA15.Signal=S_TIM2_CH1_ETR
PA2.Signal=S_TIM2_CH3
PA3.Signal=S_TIM2_CH4
PA4.Signal=ADCx_IN4
PA5.Signal=ADCx_IN5
PA6.Signal=S_TIM3_CH1
PA7.Signal=S_TIM3_CH2
PA9.Signal=USART1_TX
PB0.Signal=S_TIM3_CH3
PB1.Signal=S_TIM3_CH4
PB10.GPIO_Label=SCL_Boost
PB10.Signal=GPIO_Input
PB11.GPIO_Label=SDA_Boost
PB11.Signal=GPIO_Input
PB12.GPIO_Label=boostWkUp
PB12.Signal=GPIO_Output
PB13.GPIO_Label=powerOn
PB13.Signal=GPIO_Output
PB2.GPIO_Label=IRQ_Boost
PB2.Signal=GPIO_Input
PB3.Signal=S_TIM2_CH2
PB4.GPIO_Label=LED2
PB4.Signal=GPIO_Output
PB5.GPIO_Label=EN_5V
PB5.Signal=GPIO_Output
PB6.Signal=S_TIM4_CH1
PB7.Signal=S_TIM4_CH2
PB8.Signal=S_TIM4_CH3
PB9.Signal=S_TIM4_CH4
PC13-TAMPER-RTC.GPIO_Label=LED1
PC13-TAMPER-RTC.Signal=GPIO_Output
PC14-OSC32_IN.Signal=RCC_OSC32_IN
PC15-OSC32_OUT.Signal=RCC_OSC32_OUT
PD0-OSC_IN.Signal=RCC_OSC_IN
PD1-OSC_OUT.Signal=RCC_OSC_OUT
