RuzickaOndra/Aurora/FW/MermaidControlUnit_A/Core/Inc/main.h

#define LED1_Pin GPIO_PIN_13
#define LED1_GPIO_Port GPIOC
#define IRQ_Boost_Pin GPIO_PIN_2
#define IRQ_Boost_GPIO_Port GPIOB
#define SCL_Boost_Pin GPIO_PIN_10
#define SCL_Boost_GPIO_Port GPIOB
#define SDA_Boost_Pin GPIO_PIN_11
#define SDA_Boost_GPIO_Port GPIOB
#define boostWkUp_Pin GPIO_PIN_12
#define boostWkUp_GPIO_Port GPIOB
#define powerOn_Pin GPIO_PIN_13
#define powerOn_GPIO_Port GPIOB
#define LED2_Pin GPIO_PIN_4
#define LED2_GPIO_Port GPIOB
#define EN_5V_Pin GPIO_PIN_5
#define EN_5V_GPIO_Port GPIOB
