RuzickaOndra/Aurora/FW/MermaidControlUnit_A/Core/Inc/tim.h

/*
 * tim.h
 *
 *  Created on: Feb 23, 2025
 *      Author: ondra
 */

#ifndef INC_TIM_H_
#define INC_TIM_H_

//for the stupid WS28XX library, which needs this file
#include "stm32f1xx_hal.h"

#endif /* INC_TIM_H_ */
