RuzickaOndra/Aurora/(commit log)

2024-12-03 barebone neopiixel not working
    [main.c, main.h]
2024-12-23 hw project init
    [MermaidControlUnit.kicad_pcb, MermaidControlUnit.kicad_sch, STM32.kicad_sch, levelShifter.kicad_sch, outputs.kicad_sch, powering.kicad_sch, wirelessCharging.kicad_sch]
2024-12-26 folders reorganized, schematic progress
    [MermaidControlUnit.kicad_sch, levelShifter.kicad_sch, outputs.kicad_sch, powering.kicad_sch]
2024-12-28 HW design progress
    [MermaidControlUnit.kicad_pcb, MermaidControlUnit.kicad_sch, STM32.kicad_sch, levelShifter.kicad_sch, outputs.kicad_sch, powering.kicad_sch, wirelessCharging.kicad_sch]
2024-12-29 hw progress
    [MermaidControlUnit.kicad_pcb, MermaidControlUnit.kicad_sch, STM32.kicad_sch, outputs.kicad_sch, powering.kicad_sch, wirelessCharging.kicad_sch]
2025-01-17 production rev A
    [BOM_MermaidControlUnit.csv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]
2025-02-04 schematic added, folder structure updated
    [MermaidControlUnit-B_Cu.gbr, MermaidControlUnit-B_Mask.gbr, MermaidControlUnit-Edge_Cuts.gbr, MermaidControlUnit-F_Cu.gbr, MermaidControlUnit-F_Mask.gbr, MermaidControlUnit-F_Paste.gbr, MermaidControlUnit-F_Silkscreen.gbr, MermaidControlUnit-NPTH.drl]
2025-03-04 BQ NTC retuned
    [MermaidControlUnit.kicad_pcb, wirelessCharging.kicad_sch]
